Hieudo02/NODEVOTE_EMG/README.md

V2 là bản Node nút vuông, V3 là bản Node nút tròn.
GW ở V3 dùng được cho Node ở cả V2 và V3
