Hieudo02/NODEVOTE_EMG/Hardware/Gateway/Các files thiết kế/GatewayVote_V2.0/GatewayVote_V2.0_BOT.png

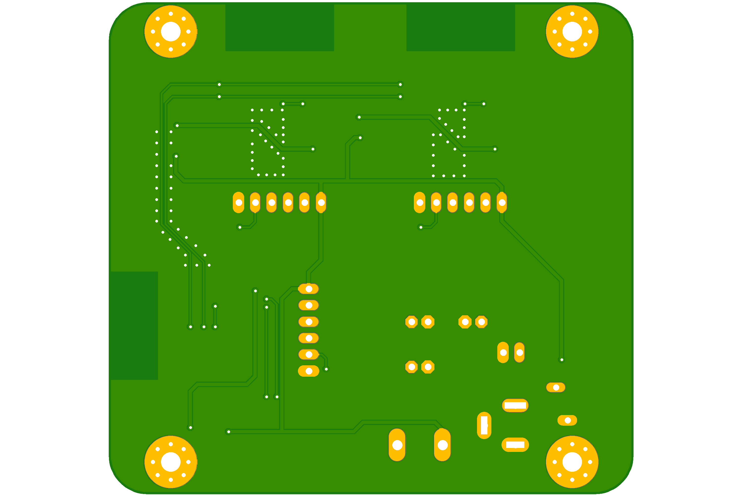
Hardware/Gateway/Các files thiết kế/GatewayVote_V2.0/GatewayVote_V2.0_BOT.png
