Hieudo02/NODEVOTE_EMG/Hardware/Gateway/Các files thiết kế/GatewayVote_V2.0/GatewayVote_V2.0.brd

## EAGLE design Hardware/Gateway/Các files thiết kế/GatewayVote_V2.0/GatewayVote_V2.0.brd (2024-02-19)

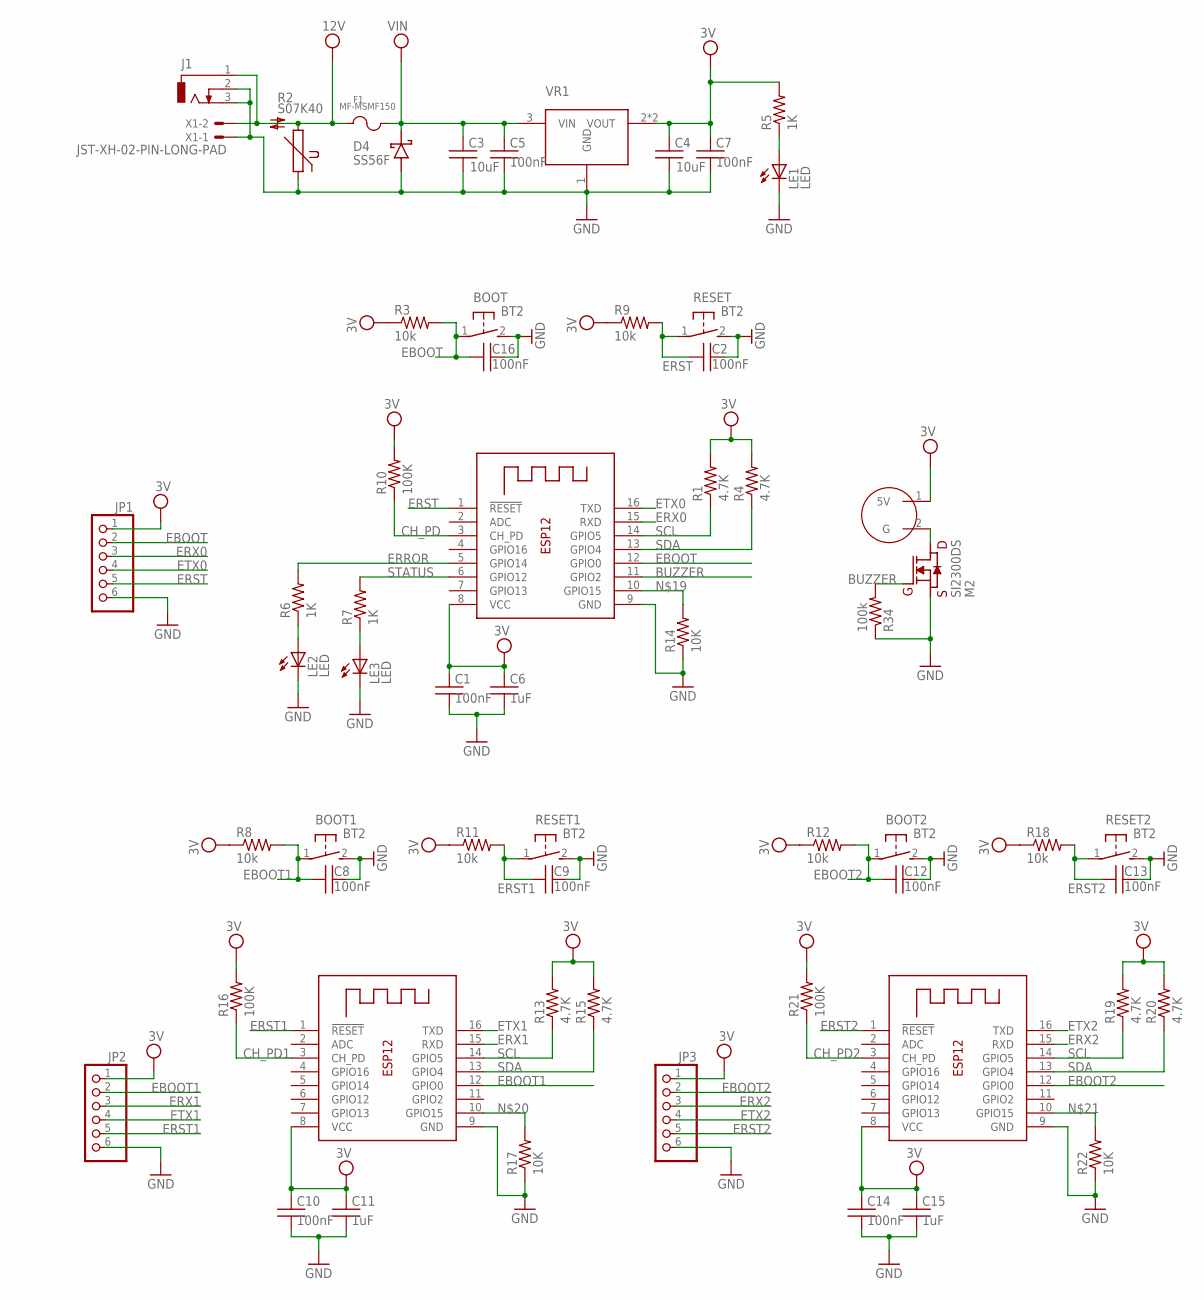
[picture p20: schematic GatewayVote_V2.0.sch]

Parts:
BOOT, BOOT1, BOOT2: BT2
C1, C2, C5, C7, C8, C9, C10, C12, C13, C14, C16: 100nF; 0603
C3, C4: 10uF; 0603
C6, C11, C15: 1uF; 0603
D4: SS56F; SMB
F1: MF-MSMF150; FUSER_MF-MSMF150
J1: DCJ0303
JP1, JP2, JP3: PINHD-1X6; 1X06
LE1, LE2, LE3: LED; LED3MM
M2: SI2300DS; SOT23(1)
R1, R4, R13, R15, R19, R20: 4.7K; 0603
R2: S07K40
R3, R8, R9, R11, R12, R18: 10k; 0603
R5, R6, R7: 1K; 0603
R10, R16, R21: 100K; 0603
R14, R17, R22: 10K; 0603
R34: 100k; 0603
RESET, RESET1, RESET2: BT2
U$3: BUZZER-5V
VR1: LD1085D2M33R; VREG_LD1085D2M33R
X1: JST-XH-02-PIN-LONG-PAD; JST-XH-02-PACKAGE-LONG-PAD
X2, X3, X4: ESP-12

Connections:
3V: C1.1, C4.1, C6.1, C7.1, C10.1, C11.1, C14.1, C15.1, JP1.1, JP2.1, JP3.1, R1.2, R3.1, R4.2, R5.2, R8.1, R9.1, R10.2, R11.1, R12.1, R13.2, R15.2, R16.2, R18.1, R19.2, R20.2, R21.2, U$3.1 (5V), VR1.2 (VOUT), VR1.4 (VOUT), X2.8 (VCC), X3.8 (VCC), X4.8 (VCC)
12V: F1.1, J1.1, R2.2, X1.2
BUZZER: M2.1 (G), R34.2, X2.11 (GPIO2)
CH_PD: R10.1, X2.3 (CH_PD)
CH_PD1: R16.1, X3.3 (CH_PD)
CH_PD2: R21.1, X4.3 (CH_PD)
EBOOT: BOOT.1, C16.1, JP1.2, R3.2, X2.12 (GPIO0)
EBOOT1: BOOT1.1, C8.1, JP2.2, R8.2, X3.12 (GPIO0)
EBOOT2: BOOT2.1, C12.1, JP3.2, R12.2, X4.12 (GPIO0)
ERROR: R6.2, X2.5 (GPIO14)
ERST: C2.1, JP1.5, R9.2, RESET.1, X2.1 (!RESET)
ERST1: C9.1, JP2.5, R11.2, RESET1.1, X3.1 (!RESET)
ERST2: C13.1, JP3.5, R18.2, RESET2.1, X4.1 (!RESET)
ERX0: JP1.3, X2.15 (RXD)
ERX1: JP2.3, X3.15 (RXD)
ERX2: JP3.3, X4.15 (RXD)
ETX0: JP1.4, X2.16 (TXD)
ETX1: JP2.4, X3.16 (TXD)
ETX2: JP3.4, X4.16 (TXD)
GND: BOOT.2, BOOT1.2, BOOT2.2, C1.2, C2.2, C3.2, C4.2, C5.2, C6.2, C7.2, C8.2, C9.2, C10.2, C11.2, C12.2, C13.2, C14.2, C15.2, C16.2, D4.A, J1.2, J1.3, JP1.6, JP2.6, JP3.6, LE1.K (C), LE2.K (C), LE3.K (C), M2.2 (S), R2.1, R14.1, R17.1, R22.1, R34.1, RESET.2, RESET1.2, RESET2.2, VR1.1 (GND), X1.1, X2.9 (GND), X3.9 (GND), X4.9 (GND)
unnamed: M2.3 (D), U$3.2 (G)
unnamed: LE2.A, R6.1
unnamed: LE3.A, R7.1
unnamed: R14.2, X2.10 (GPIO15)
unnamed: R17.2, X3.10 (GPIO15)
unnamed: R22.2, X4.10 (GPIO15)
unnamed: LE1.A, R5.1
SCL: R1.1, R13.1, R19.1, X2.14 (GPIO5), X3.14 (GPIO5), X4.14 (GPIO5)
SDA: R4.1, R15.1, R20.1, X2.13 (GPIO4), X3.13 (GPIO4), X4.13 (GPIO4)
STATUS: R7.2, X2.6 (GPIO12)
VIN: C3.1, C5.1, D4.C, F1.2, VR1.3 (VIN)

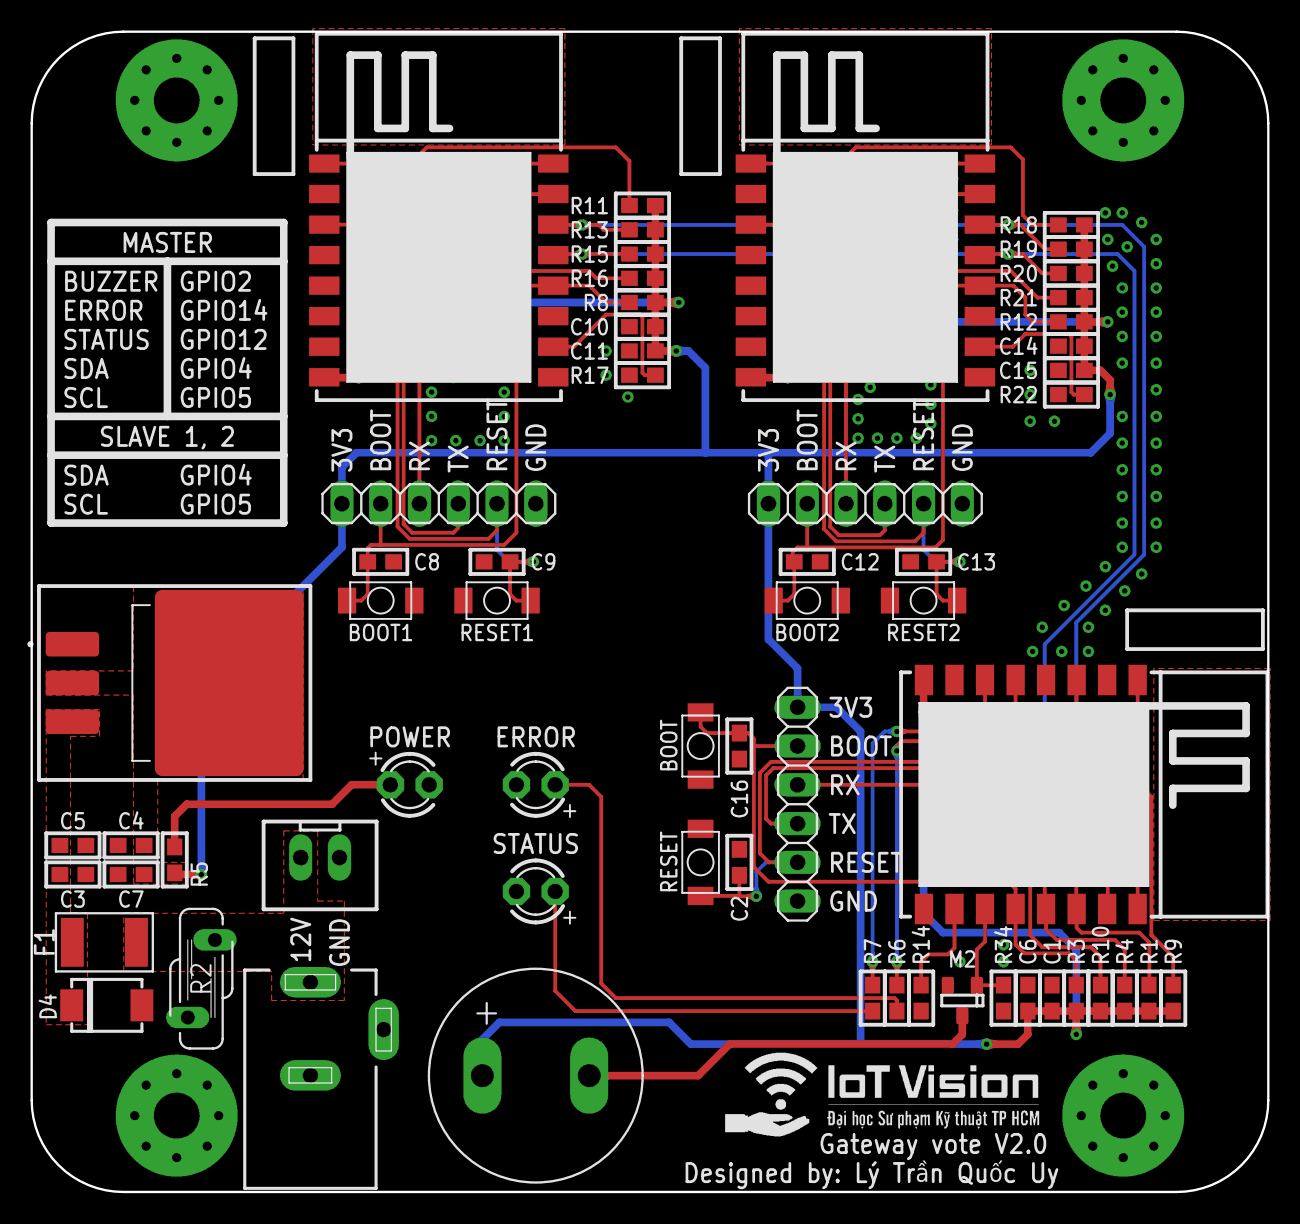
[picture p21: board GatewayVote_V2.0.brd from above]

Board: 2 copper layers, 81.0 x 76.0 mm, 62 parts (0 on the bottom side), 31 nets.

Other parts of the board:
U$2: 1.2MIL
