Hieudo02/NODEVOTE_EMG/V3/VoteGWSlave1/04_ESPNow.h

#ifndef _ESPNow_h
#define _ESPNow_h

#include "VoteGWSlave1.h"  // Có define debug để bật/tắt các debug ra Serial.
#include <Arduino.h>
#include <espnow.h>
#include <ESP8266WiFi.h>

// VECTOR
#include <vector>
#include <algorithm>
#include <string>

#define MAX_CHANNEL 14  // for North America // 13 in Europe
const int DATA_SIZE = 18;

class ESPNOW {
public:
  static int32_t WiFiChannel;
  static int8_t channels[];
  static int currentChannelIndex;
  
  static char MACMaster[13];
  static uint8_t MACMasterDungDinhDang[6];
  static char DapAn;                      // Đáp án 0-1-2-3 -> A-B-C-D
  static char IDTuyChinhCuaSlave;
  static uint8_t MacCuaNodeGuiToiSlave[6];
  static char IDCuaSlave[3];
  static char DuLieuGuiToiMasTer[DATA_SIZE];
  static bool FlagBatTay;

  static std::vector<std::string> FIFODataCuaNodeGuiLenMaster;

public:
  void KhoiTao(int role);  // Khởi tạo ESP-NOW với role (vai trò master-slave).

private:
  static void TrangThaiGuiGoiTinCuaSlave(uint8_t *mac_addr, uint8_t sendStatus);
  static void DuLieuNhanTuNode(uint8_t* MAC, uint8_t* DuLieu, uint8_t ChieuDaiDuLieu);
};

#endif
