Hieudo02/NODEVOTE_EMG/V3/VoteGWMaster/00_ChuongTrinhChinh.h

#ifndef _ChuongTrinhChinh_h
#define _ChuongTrinhChinh_h

#include "VoteGWMaster.h"  // Có define debug để bật/tắt các debug ra Serial.

void KhoiTao(void);               //
void ChayChuongTrinhChinh(void);  //
void ThucThiTacVuTheoFLAG(void);  //

#endif
